Harry3156/arduino-heater-block-pid/images/Fan_input.png

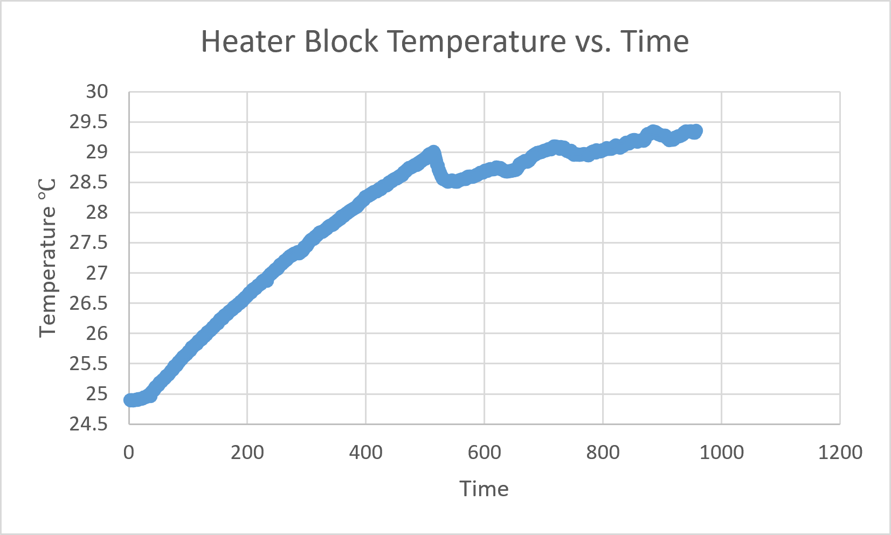
images/Fan_input.png
