Harry3156/arduino-heater-block-pid/images/Fan_response.png

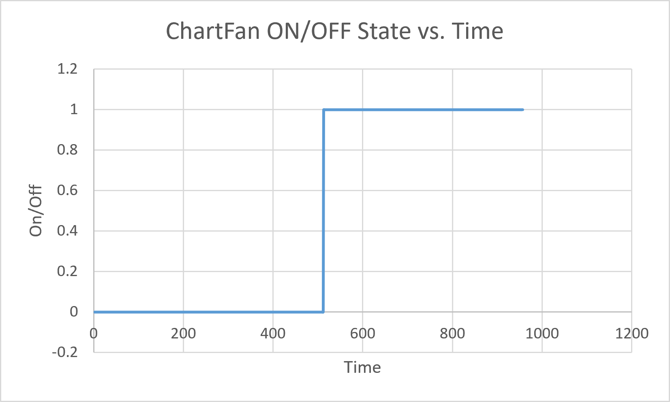
images/Fan_response.png
