Harry3156/arduino-heater-block-pid/images/Steadystate.png

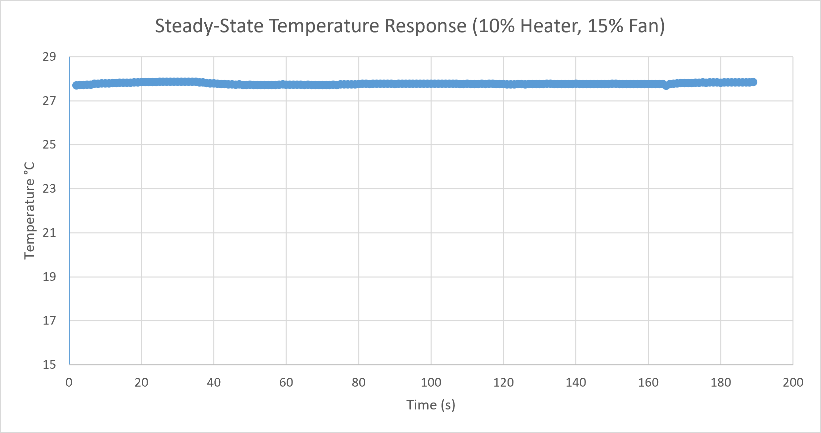
images/Steadystate.png
